jacoboropero-web/segunda-entrega-proyecto/imagenes/3d_vista_inferior.png

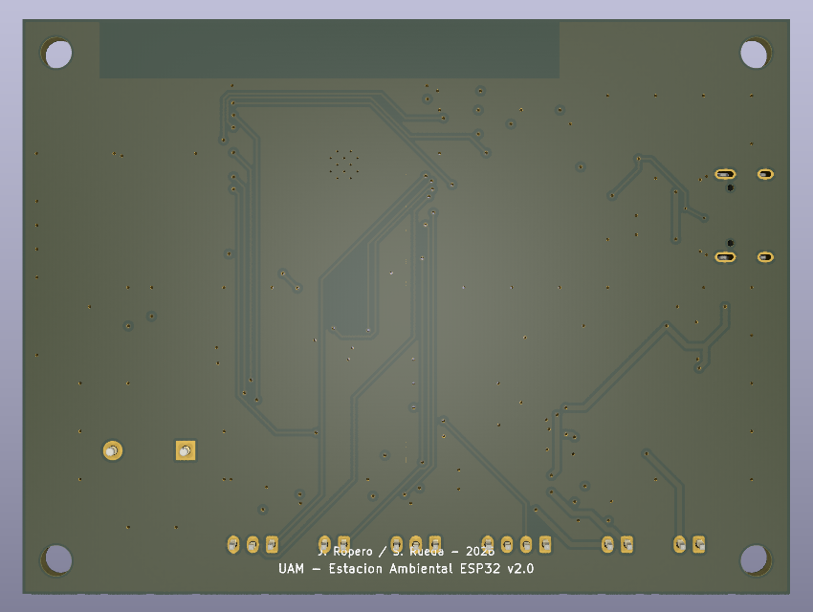
imagenes/3d_vista_inferior.png
