jacoboropero-web/segunda-entrega-proyecto/imagenes/3d_vista_superior.png

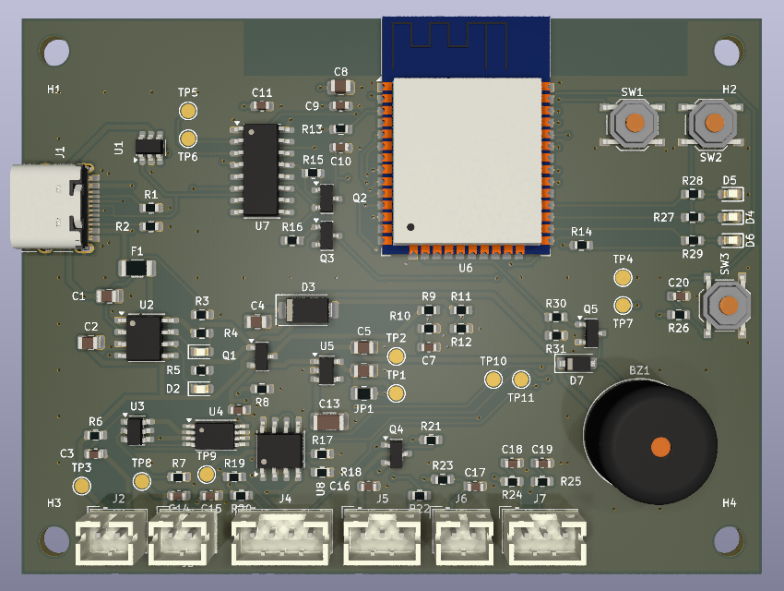
imagenes/3d_vista_superior.png
