jacoboropero-web/segunda-entrega-proyecto/imagenes/3d_perspectiva.png

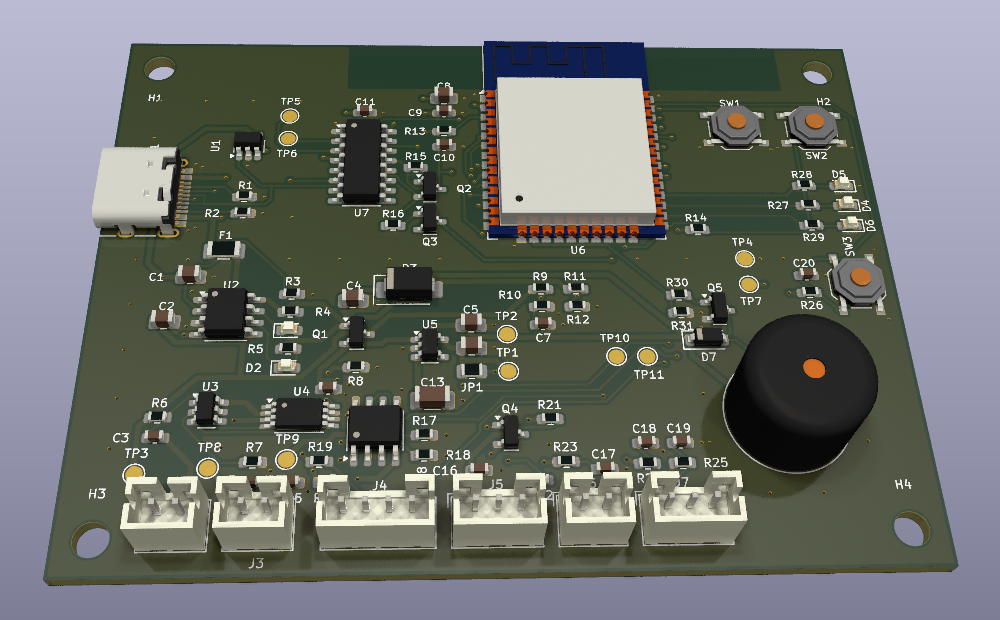
imagenes/3d_perspectiva.png
