jacoboropero-web/segunda-entrega-proyecto/imagenes/erc_kicad_0_errores.png

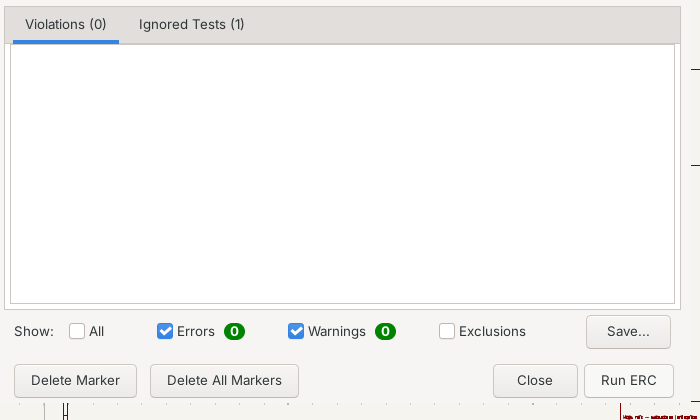
imagenes/erc_kicad_0_errores.png
