jacoboropero-web/segunda-entrega-proyecto/imagenes/esquema_alimentacion.png

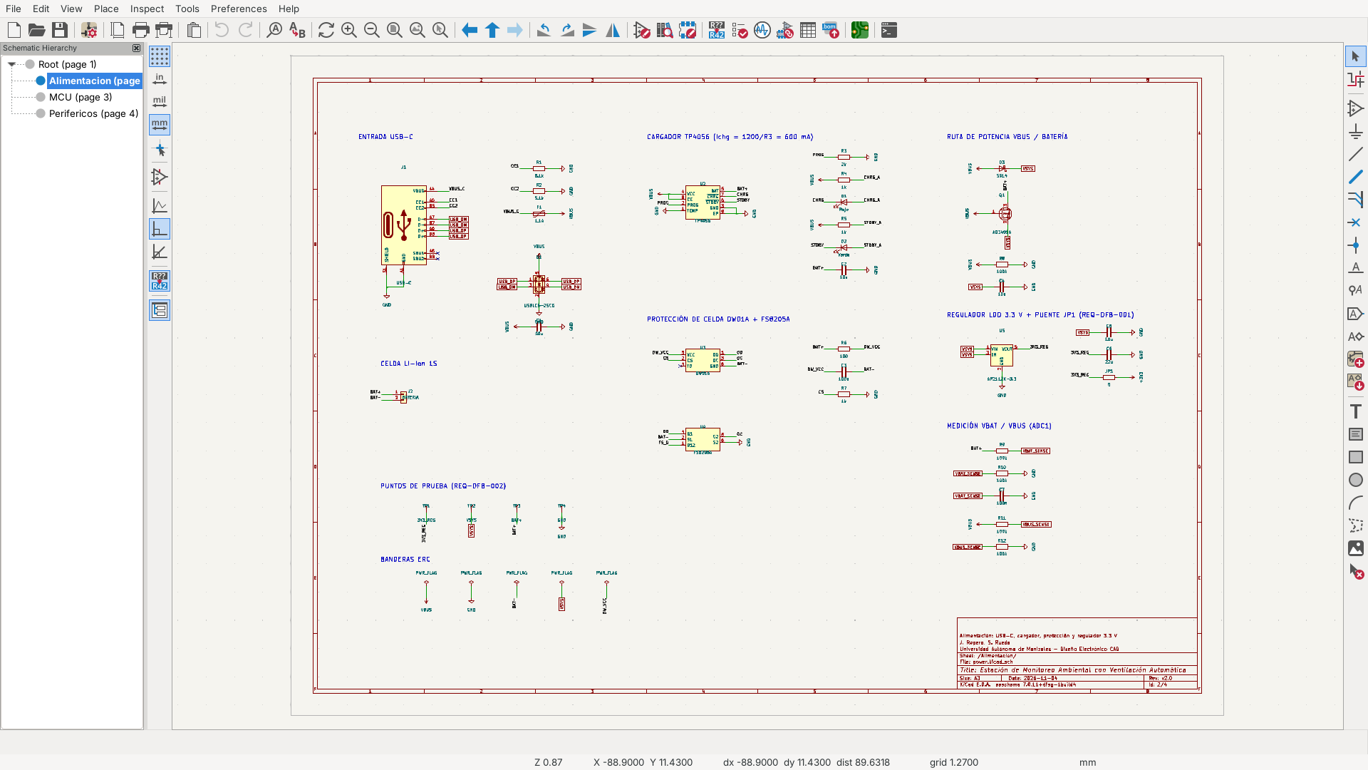
imagenes/esquema_alimentacion.png
