jacoboropero-web/segunda-entrega-proyecto/imagenes/esquema_hoja_raiz.png

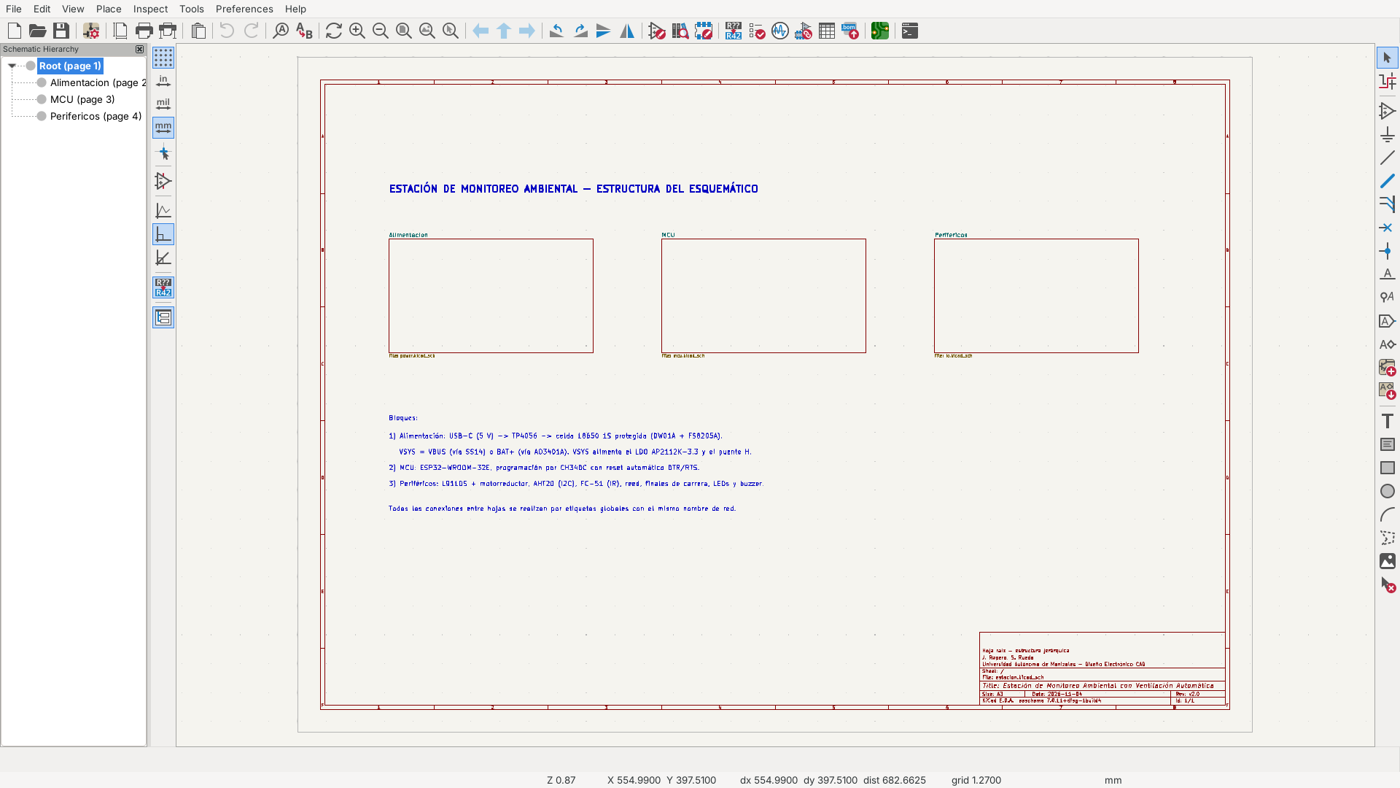
imagenes/esquema_hoja_raiz.png
