jacoboropero-web/segunda-entrega-proyecto/imagenes/esquema_mcu.png

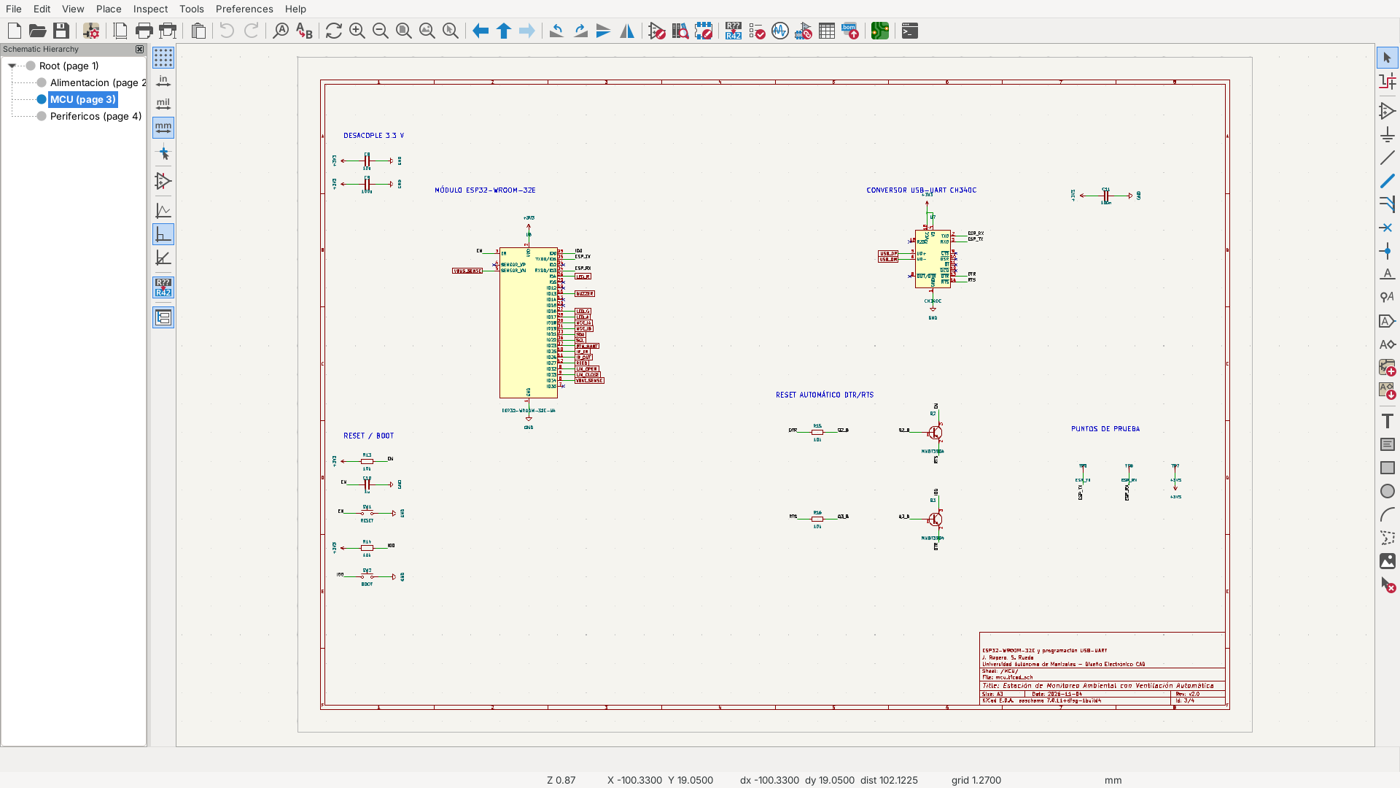
imagenes/esquema_mcu.png
