jacoboropero-web/segunda-entrega-proyecto/imagenes/esquema_perifericos.png

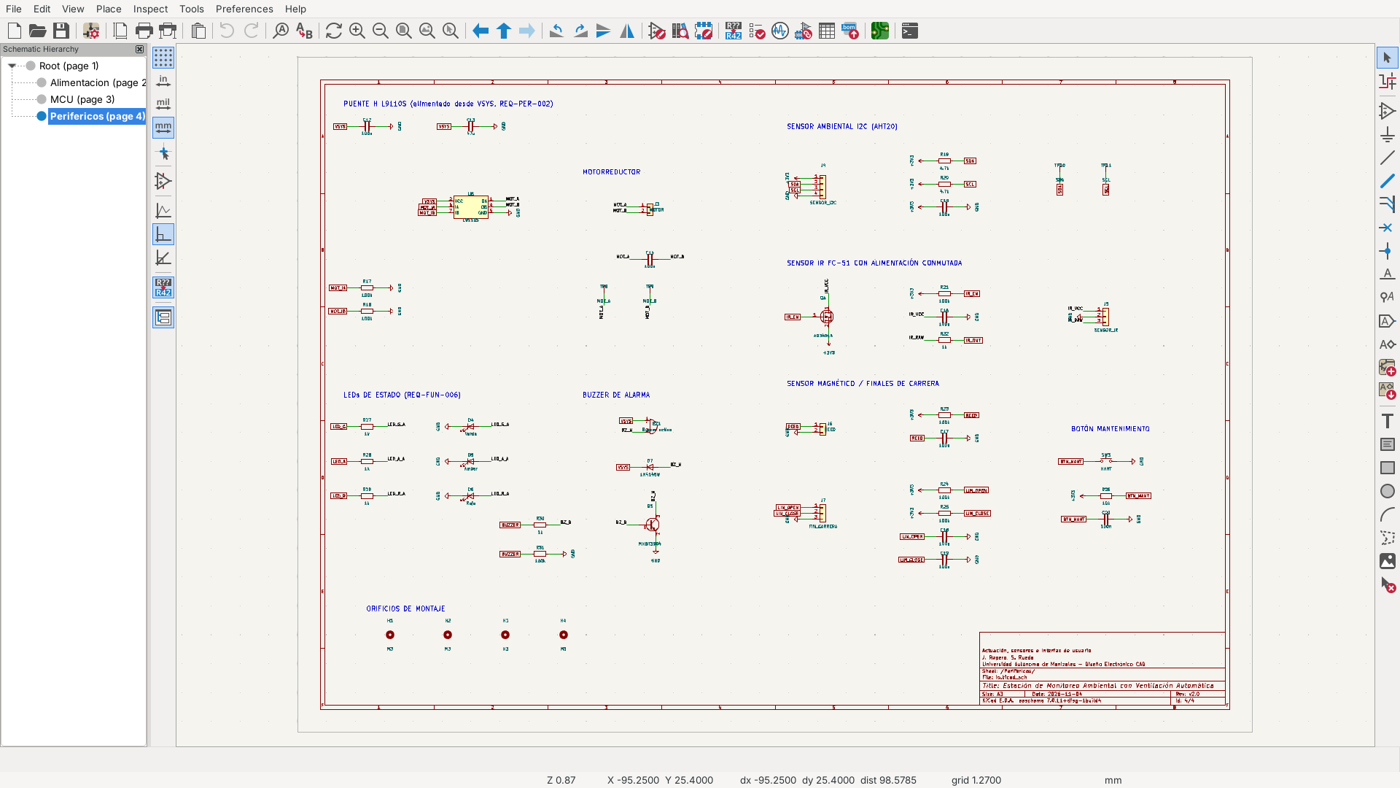
imagenes/esquema_perifericos.png
