jacoboropero-web/segunda-entrega-proyecto/imagenes/layout_kicad.png

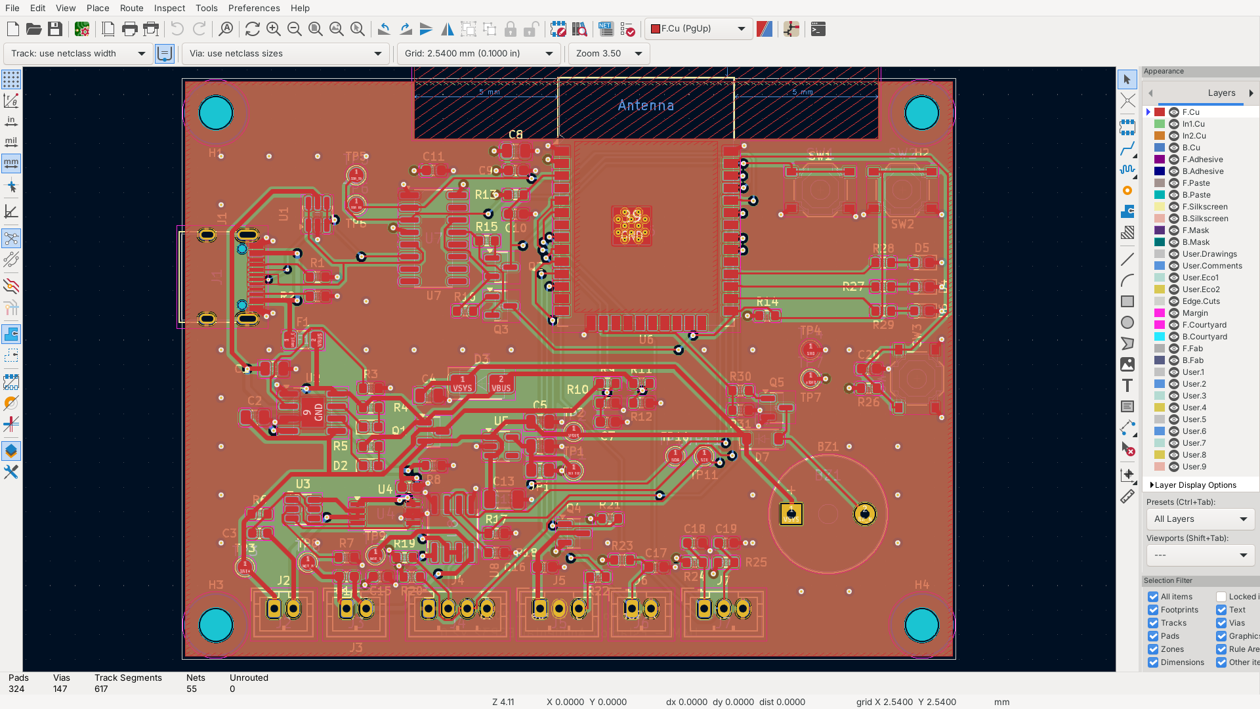
imagenes/layout_kicad.png
