jacoboropero-web/segunda-entrega-proyecto/imagenes/pistas_capas_superior_inferior.png

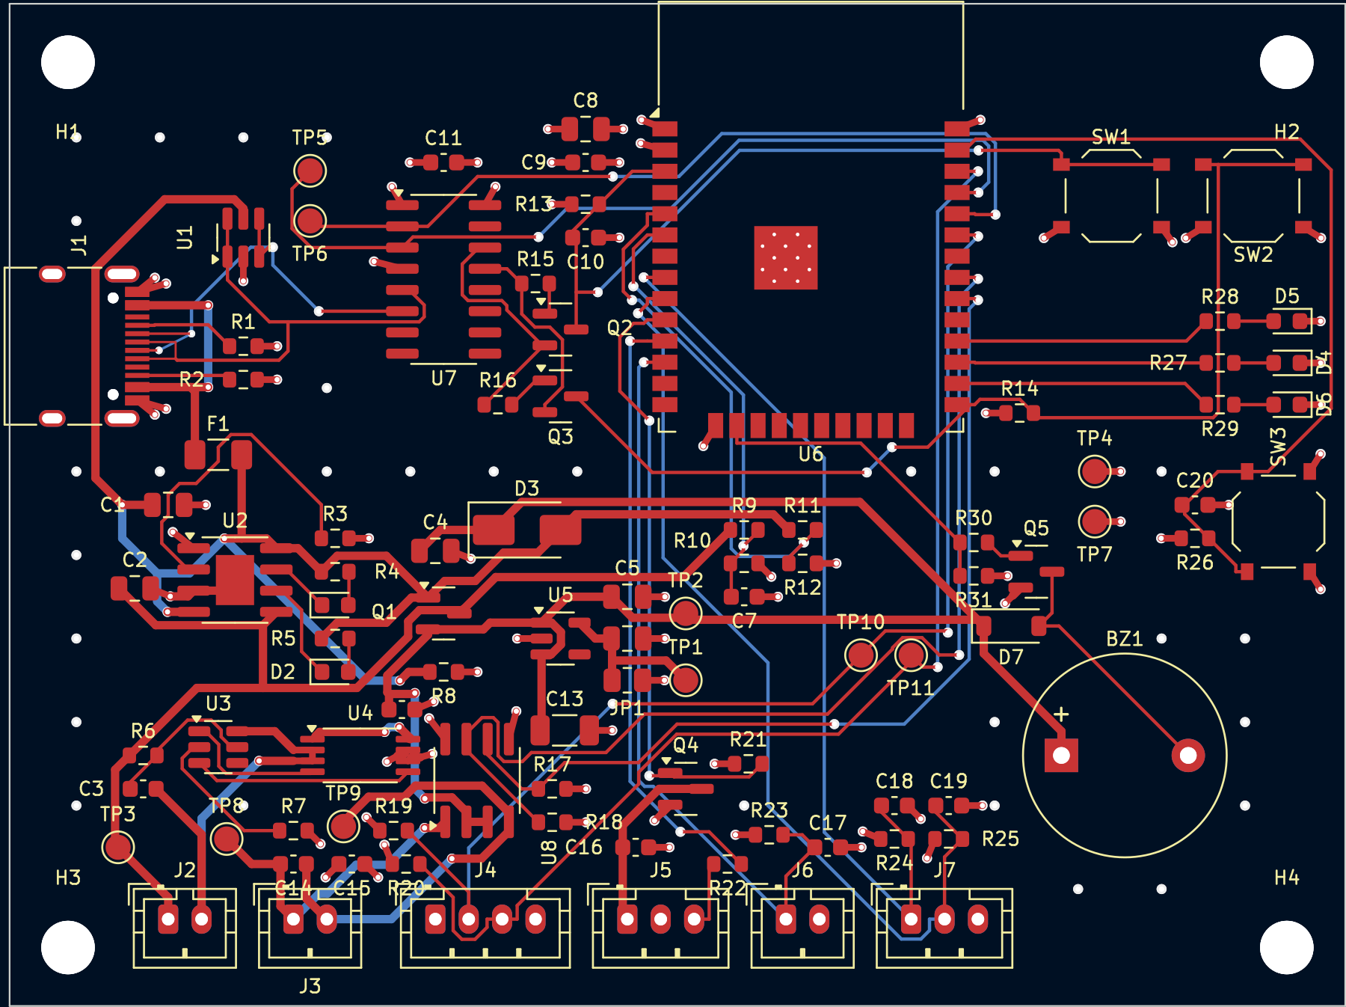
imagenes/pistas_capas_superior_inferior.png
