jacoboropero-web/segunda-entrega-proyecto/imagenes/ratsnest_conexiones_kicad.png

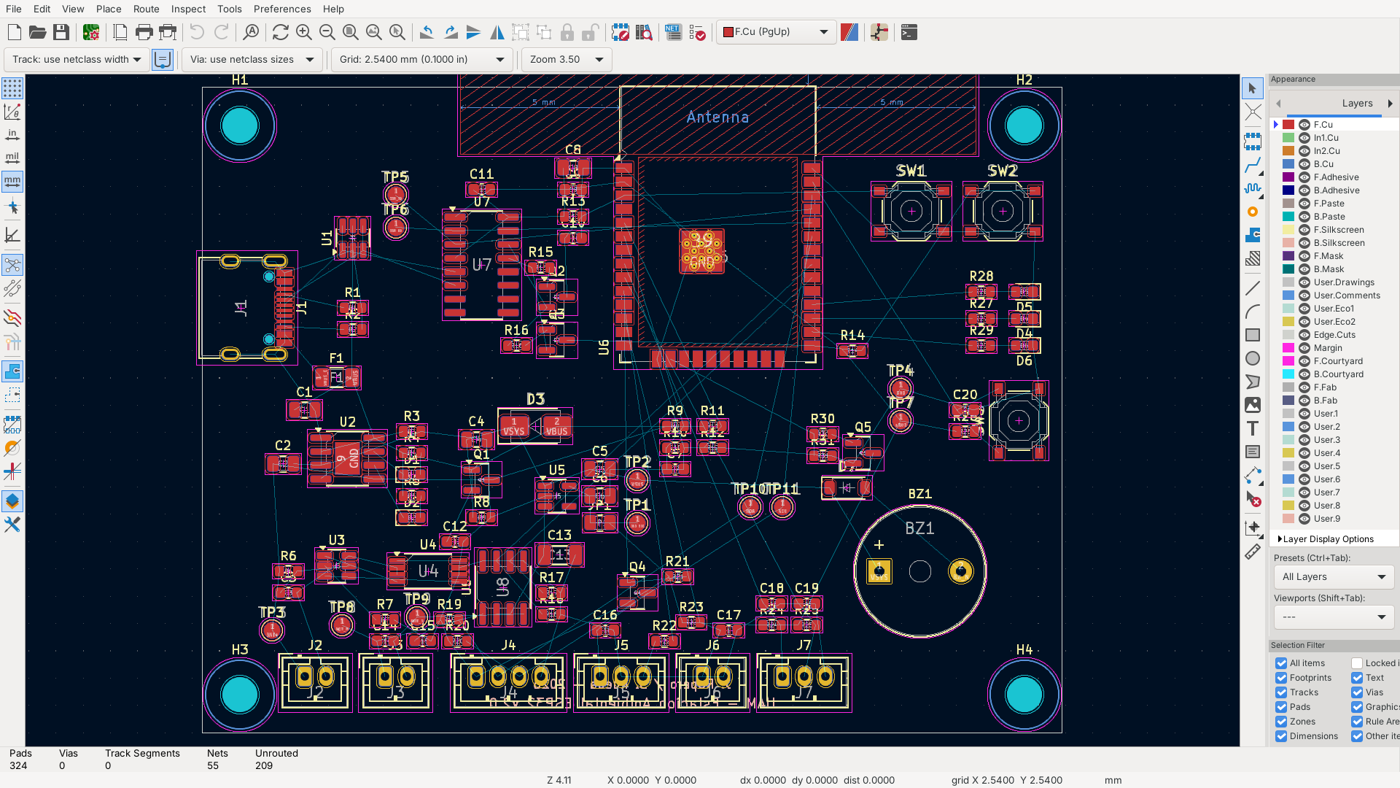
imagenes/ratsnest_conexiones_kicad.png
