jacoboropero-web/segunda-entrega-proyecto/hardware/estacion_kicad/fab/estacion-BOM-JLCPCB.csv

Comment | Designator | Footprint | LCSC Part #
USB-C | J1 | USB_C_Receptacle_HRO_TYPE-C-31-M-12 | C165948
5.1k | R1,R2 | R_0603_1608Metric
1.1A | F1 | Fuse_1206_3216Metric
USBLC6-2SC6 | U1 | SOT-23-6 | C7519
10u | C1,C2,C4,C5,C8 | C_0805_2012Metric
TP4056 | U2 | SOIC-8-1EP_3.9x4.9mm_P1.27mm_EP2.29x3mm | C16581
2k | R3 | R_0603_1608Metric
1k | R4,R5,R7,R22,R27,R28,R29,R30 | R_0603_1608Metric
Rojo | D1,D6 | LED_0603_1608Metric
Verde | D2,D4 | LED_0603_1608Metric
DW01A | U3 | SOT-23-6 | C351410
FS8205A | U4 | TSSOP-8_4.4x3mm_P0.65mm | C16052
100 | R6 | R_0603_1608Metric
100n | C3,C7,C9,C11,C12,C14,C15,C16,C17,C18,C19,C20 | C_0603_1608Metric
SS14 | D3 | D_SMA | C2480
AO3401A | Q1,Q4 | SOT-23 | C15127
100k | R8,R9,R10,R11,R12,R17,R18,R21,R23,R24,R25,R31 | R_0603_1608Metric
AP2112K-3.3 | U5 | SOT-23-5 | C51118
22u | C6 | C_0805_2012Metric
0 | JP1 | R_0805_2012Metric
ESP32-WROOM-32E-N4 | U6 | ESP32-WROOM-32D | C701341
10k | R13,R14,R15,R16,R26 | R_0603_1608Metric
1u | C10 | C_0603_1608Metric
RESET | SW1 | SW_Push_1P1T_XKB_TS-1187A | C318884
BOOT | SW2 | SW_Push_1P1T_XKB_TS-1187A | C318884
CH340C | U7 | SOIC-16_3.9x9.9mm_P1.27mm | C84681
MMBT3904 | Q2,Q3,Q5 | SOT-23 | C20526
L9110S | U8 | SOIC-8_3.9x4.9mm_P1.27mm | C85174
47u | C13 | C_1206_3216Metric
4.7k | R19,R20 | R_0603_1608Metric
MANT | SW3 | SW_Push_1P1T_XKB_TS-1187A | C318884
Ambar | D5 | LED_0603_1608Metric
1N4148W | D7 | D_SOD-123 | C81598
