jacoboropero-web/segunda-entrega-proyecto/hardware/estacion_kicad/fab/estacion-BOM.csv

Comment | Designator | Footprint | Cantidad | MPN | LCSC | Tipo | Clase | Precio_USD | Subtotal_USD
USB-C | J1 | USB_C_Receptacle_HRO_TYPE-C-31-M-12 | 1 | HRO TYPE-C-31-M-12 | C165948 | SMD | Extendida | 0.15 | 0.15
5.1k | R1,R2 | R_0603_1608Metric | 2 | 0603 5.1k 1% | (básico JLC) | SMD | Básica | 0.01 | 0.02
1.1A | F1 | Fuse_1206_3216Metric | 1 | 1206L110 (PTC 1.1 A) |  | SMD | Extendida | 0.03 | 0.03
USBLC6-2SC6 | U1 | SOT-23-6 | 1 | USBLC6-2SC6 | C7519 | SMD | Básica | 0.1 | 0.1
10u | C1,C2,C4,C5,C8 | C_0805_2012Metric | 5 | 10uF 16V X5R 0805 | (básico JLC) | SMD | Básica | 0.01 | 0.05
TP4056 | U2 | SOIC-8-1EP_3.9x4.9mm_P1.27mm_EP2.29x3mm | 1 | TP4056 (ESOP-8) | C16581 | SMD | Extendida | 0.1 | 0.1
2k | R3 | R_0603_1608Metric | 1 | 0603 2k 1% | (básico JLC) | SMD | Básica | 0.01 | 0.01
1k | R4,R5,R7,R22,R27,R28,R29,R30 | R_0603_1608Metric | 8 | 0603 1k 1% | (básico JLC) | SMD | Básica | 0.01 | 0.08
Rojo | D1,D6 | LED_0603_1608Metric | 2 | LED 0603 Rojo | (básico JLC) | SMD | Básica | 0.01 | 0.02
Verde | D2,D4 | LED_0603_1608Metric | 2 | LED 0603 Verde | (básico JLC) | SMD | Básica | 0.01 | 0.02
DW01A | U3 | SOT-23-6 | 1 | DW01A | C351410 | SMD | Extendida | 0.04 | 0.04
FS8205A | U4 | TSSOP-8_4.4x3mm_P0.65mm | 1 | FS8205A | C16052 | SMD | Extendida | 0.06 | 0.06
100 | R6 | R_0603_1608Metric | 1 | 0603 100 1% | (básico JLC) | SMD | Básica | 0.01 | 0.01
100n | C3,C7,C9,C11,C12,C14,C15,C16,C17,C18,C19,C20 | C_0603_1608Metric | 12 | 100n | (básico JLC) | SMD | Básica | 0.01 | 0.12
BATERIA | J2 | JST_PH_B2B-PH-K_1x02_P2.00mm_Vertical | 1 | JST PH 2P (celda 18650 1S) |  | THT (manual) | Básica | 0.06 | 0.06
SS14 | D3 | D_SMA | 1 | SS14 40V 1A Schottky | C2480 | SMD | Básica | 0.02 | 0.02
AO3401A | Q1,Q4 | SOT-23 | 2 | AO3401A P-MOSFET | C15127 | SMD | Básica | 0.02 | 0.04
100k | R8,R9,R10,R11,R12,R17,R18,R21,R23,R24,R25,R31 | R_0603_1608Metric | 12 | 0603 100k 1% | (básico JLC) | SMD | Básica | 0.01 | 0.12
AP2112K-3.3 | U5 | SOT-23-5 | 1 | AP2112K-3.3TRG1 | C51118 | SMD | Extendida | 0.09 | 0.09
22u | C6 | C_0805_2012Metric | 1 | 22uF 10V X5R 0805 | (básico JLC) | SMD | Básica | 0.01 | 0.01
0 | JP1 | R_0805_2012Metric | 1 | Puente 0 Ohm 0805 (REQ-DFB-001) | (básico JLC) | SMD | Básica | 0.01 | 0.01
ESP32-WROOM-32E-N4 | U6 | ESP32-WROOM-32D | 1 | ESP32-WROOM-32E-N4 | C701341 | SMD | Extendida | 3.2 | 3.2
10k | R13,R14,R15,R16,R26 | R_0603_1608Metric | 5 | 0603 10k 1% | (básico JLC) | SMD | Básica | 0.01 | 0.05
1u | C10 | C_0603_1608Metric | 1 | 1u | (básico JLC) | SMD | Básica | 0.01 | 0.01
RESET | SW1 | SW_Push_1P1T_XKB_TS-1187A | 1 | TS-1187A | C318884 | SMD | Básica | 0.03 | 0.03
BOOT | SW2 | SW_Push_1P1T_XKB_TS-1187A | 1 | TS-1187A | C318884 | SMD | Básica | 0.03 | 0.03
CH340C | U7 | SOIC-16_3.9x9.9mm_P1.27mm | 1 | CH340C | C84681 | SMD | Extendida | 0.45 | 0.45
MMBT3904 | Q2,Q3,Q5 | SOT-23 | 3 | MMBT3904 | C20526 | SMD | Básica | 0.01 | 0.03
L9110S | U8 | SOIC-8_3.9x4.9mm_P1.27mm | 1 | L9110S (SOP-8) | C85174 | SMD | Extendida | 0.1 | 0.1
47u | C13 | C_1206_3216Metric | 1 | 47uF 10V X5R 1206 | (básico JLC) | SMD | Básica | 0.01 | 0.01
MOTOR | J3 | JST_PH_B2B-PH-K_1x02_P2.00mm_Vertical | 1 | JST PH 2P |  | THT (manual) | Básica | 0.06 | 0.06
SENSOR_I2C | J4 | JST_PH_B4B-PH-K_1x04_P2.00mm_Vertical | 1 | JST PH 4P (módulo AHT20) |  | THT (manual) | Básica | 0.06 | 0.06
4.7k | R19,R20 | R_0603_1608Metric | 2 | 0603 4.7k 1% | (básico JLC) | SMD | Básica | 0.01 | 0.02
SENSOR_IR | J5 | JST_PH_B3B-PH-K_1x03_P2.00mm_Vertical | 1 | JST PH 3P (módulo FC-51) |  | THT (manual) | Básica | 0.06 | 0.06
REED | J6 | JST_PH_B2B-PH-K_1x02_P2.00mm_Vertical | 1 | JST PH 2P |  | THT (manual) | Básica | 0.06 | 0.06
FIN_CARRERA | J7 | JST_PH_B3B-PH-K_1x03_P2.00mm_Vertical | 1 | JST PH 3P |  | THT (manual) | Básica | 0.06 | 0.06
MANT | SW3 | SW_Push_1P1T_XKB_TS-1187A | 1 | TS-1187A | C318884 | SMD | Básica | 0.03 | 0.03
Ambar | D5 | LED_0603_1608Metric | 1 | LED 0603 Ambar | (básico JLC) | SMD | Básica | 0.01 | 0.01
Buzzer activo | BZ1 | Buzzer_12x9.5RM7.6 | 1 | Buzzer activo 12 mm 3-5 V |  | THT (manual) | Básica | 0.3 | 0.3
1N4148W | D7 | D_SOD-123 | 1 | 1N4148W | C81598 | SMD | Básica | 0.01 | 0.01
