jacoboropero-web/segunda-entrega-proyecto/imagenes/pistas_todo_conectado_kicad.png

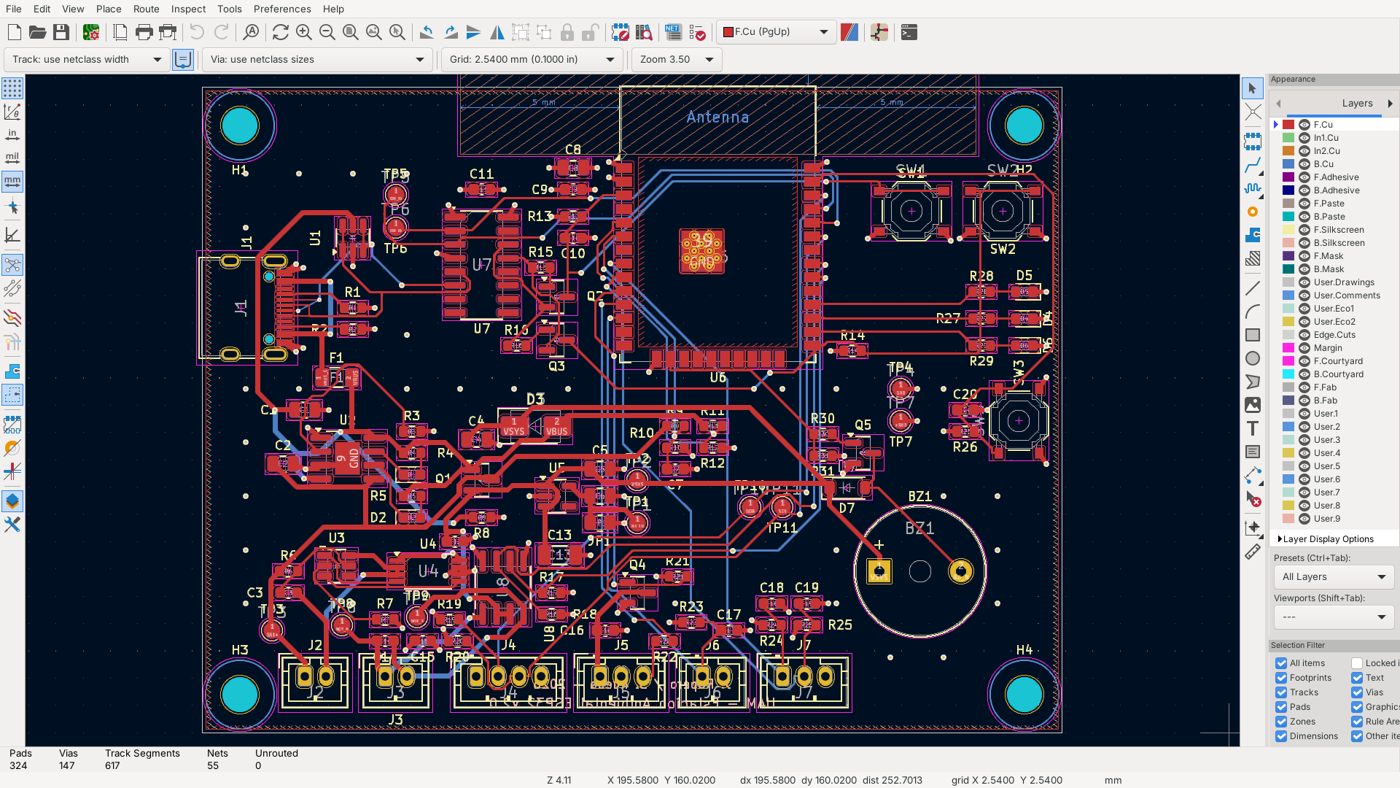
imagenes/pistas_todo_conectado_kicad.png
