jacoboropero-web/segunda-entrega-proyecto/hardware/estacion_kicad/estacion.kicad_pcb

## KiCad design hardware/estacion_kicad/estacion.kicad_pcb (2026-11-05)

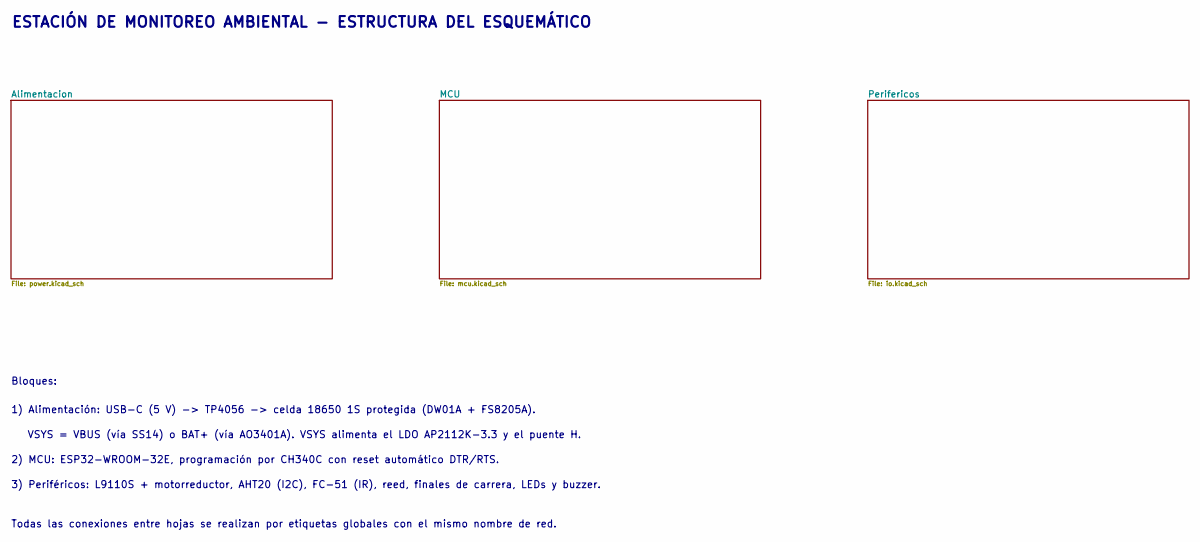
[picture p13: schematic estacion.kicad_sch, Estación de Monitoreo Ambiental con Ventilación Automática]

Notes on the sheet:
ESTACIÓN DE MONITOREO AMBIENTAL - ESTRUCTURA DEL ESQUEMÁTICO
Bloques:
1) Alimentación: USB-C (5 V) -> TP4056 -> celda 18650 1S protegida (DW01A + FS8205A).
VSYS = VBUS (vía SS14) o BAT+ (vía AO3401A). VSYS alimenta el LDO AP2112K-3.3 y el puente H.
2) MCU: ESP32-WROOM-32E, programación por CH340C con reset automático DTR/RTS.
3) Periféricos: L9110S + motorreductor, AHT20 (I2C), FC-51 (IR), reed, finales de carrera, LEDs y buzzer.
Todas las conexiones entre hojas se realizan por etiquetas globales con el mismo nombre de red.

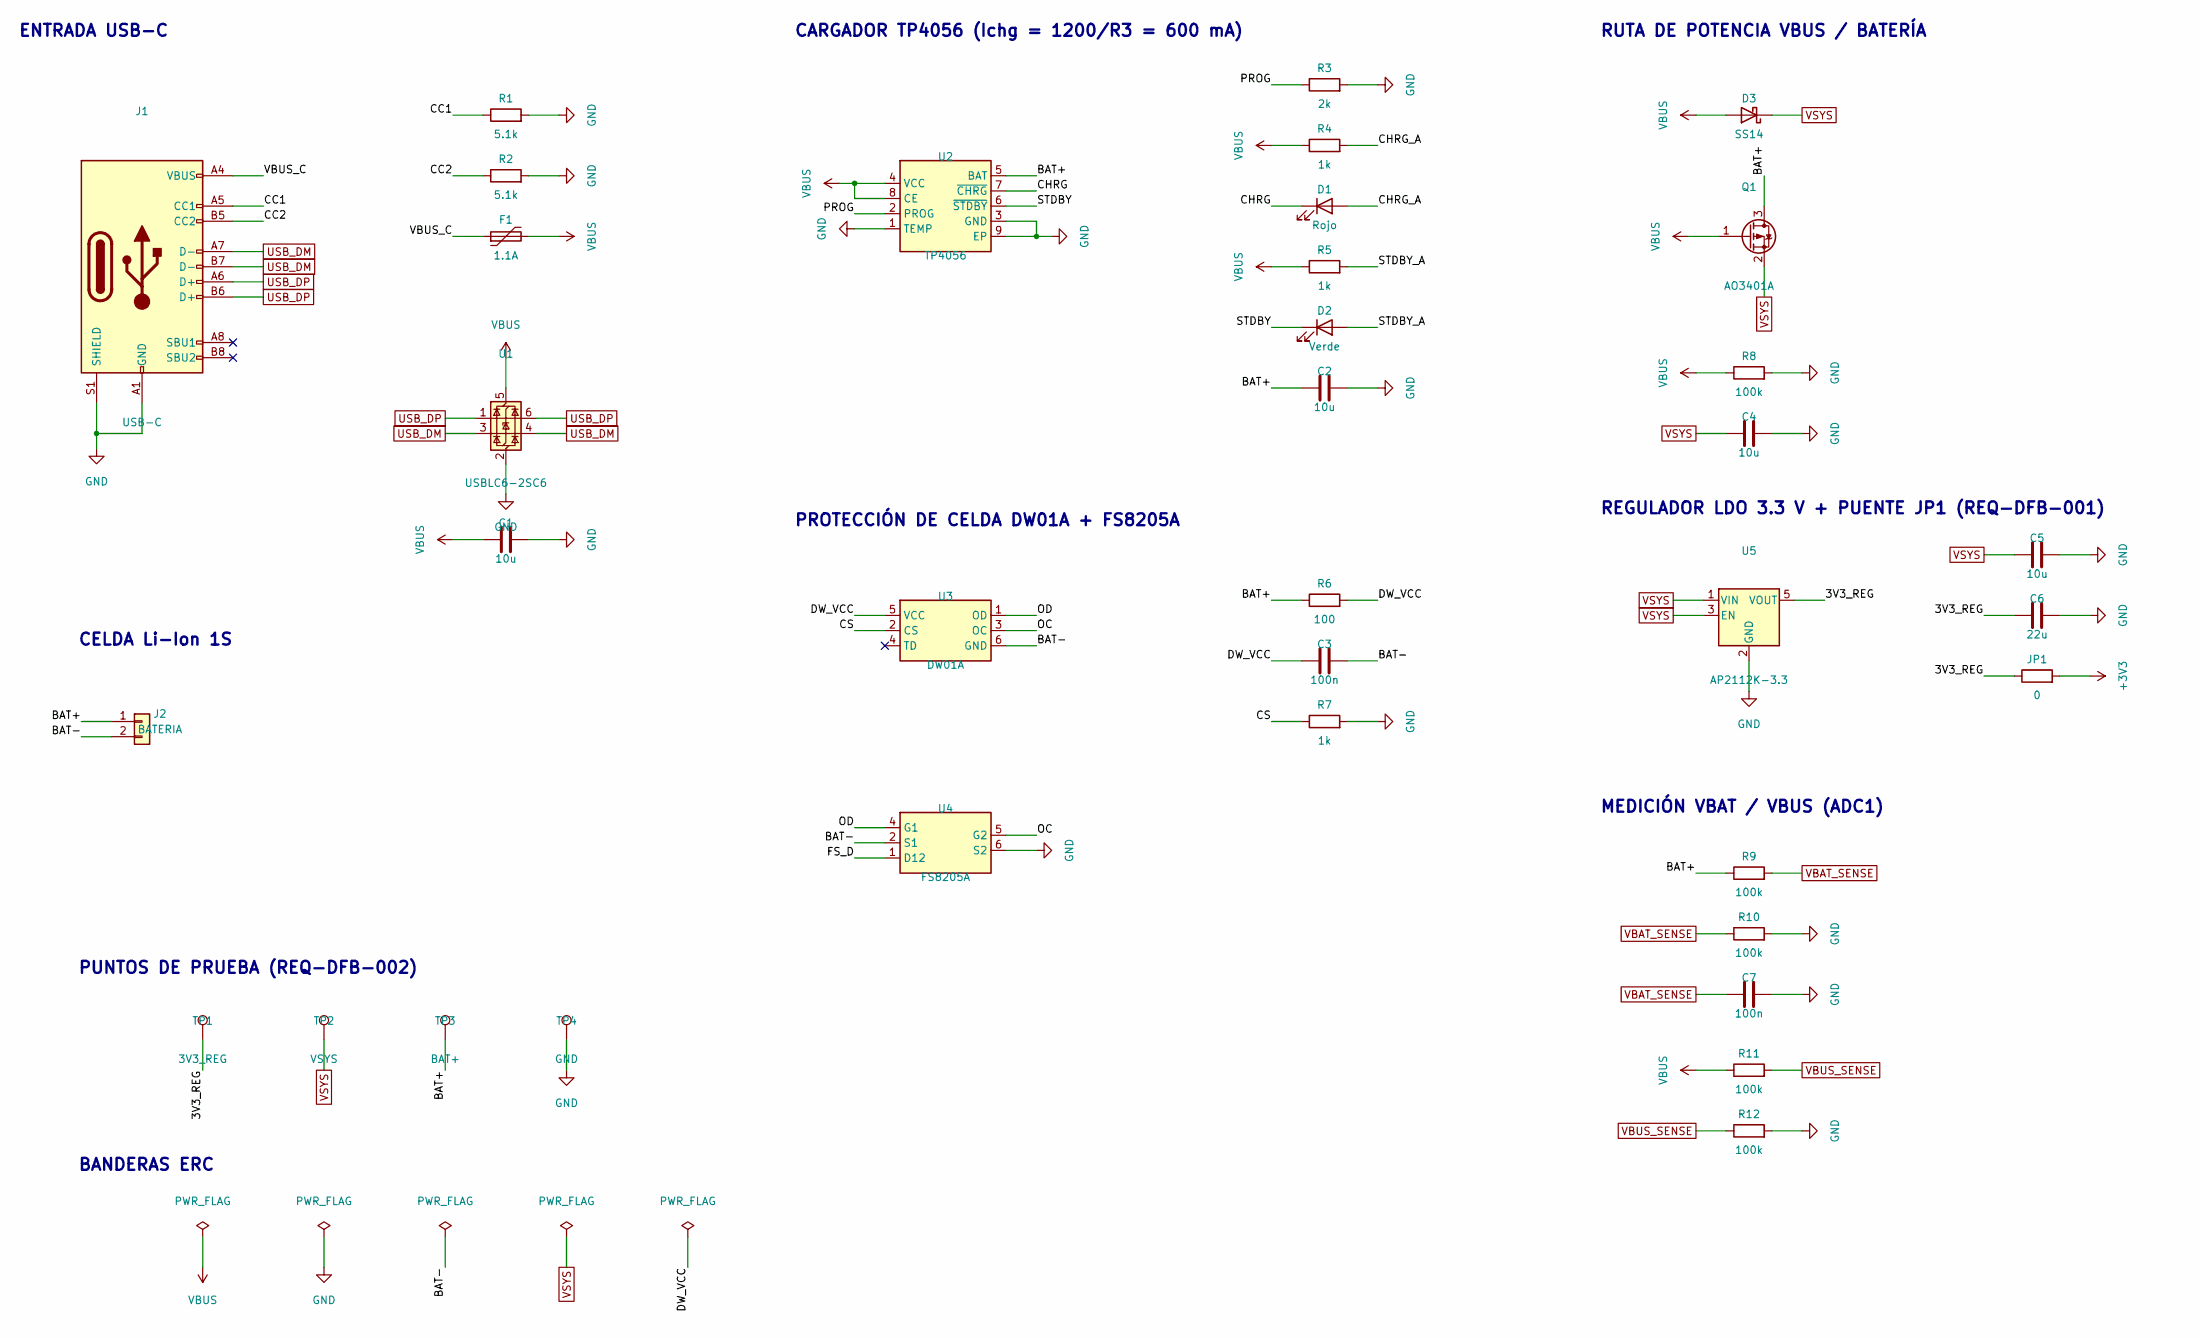
[picture p14: schematic power.kicad_sch, Estación de Monitoreo Ambiental con Ventilación Automática]

Parts:
C1, C2, C4, C5: 10u; C_0805_2012Metric; MPN 10uF 16V X5R 0805
C3, C7: 100n; C_0603_1608Metric; MPN 100n
C6: 22u; C_0805_2012Metric; MPN 22uF 10V X5R 0805
D1: Rojo; LED_0603_1608Metric; MPN LED 0603 Rojo
D2: Verde; LED_0603_1608Metric; MPN LED 0603 Verde
D3: SS14; D_SMA; MPN SS14 40V 1A Schottky
F1: 1.1A; Fuse_1206_3216Metric; MPN 1206L110 (PTC 1.1 A)
J1: USB-C; USB_C_Receptacle_HRO_TYPE-C-31-M-12; MPN HRO TYPE-C-31-M-12
J2: BATERIA; JST_PH_B2B-PH-K_1x02_P2.00mm_Vertical; MPN JST PH 2P (celda 18650 1S)
JP1: 0; R_0805_2012Metric; MPN Puente 0 Ohm 0805 (REQ-DFB-001)
Q1: AO3401A; SOT-23; MPN AO3401A P-MOSFET
R1, R2: 5.1k; R_0603_1608Metric; MPN 0603 5.1k 1%
R3: 2k; R_0603_1608Metric; MPN 0603 2k 1%
R4, R5, R7: 1k; R_0603_1608Metric; MPN 0603 1k 1%
R6: 100; R_0603_1608Metric; MPN 0603 100 1%
R8, R9, R10, R11, R12: 100k; R_0603_1608Metric; MPN 0603 100k 1%
TP1: 3V3_REG; TestPoint_Pad_D1.5mm; MPN Pad prueba 1.5 mm
TP2: VSYS; TestPoint_Pad_D1.5mm; MPN Pad prueba 1.5 mm
TP3: BAT+; TestPoint_Pad_D1.5mm; MPN Pad prueba 1.5 mm
TP4: GND; TestPoint_Pad_D1.5mm; MPN Pad prueba 1.5 mm
U1: USBLC6-2SC6; SOT-23-6; MPN USBLC6-2SC6
U2: TP4056; SOIC-8-1EP_3.9x4.9mm_P1.27mm_EP2.29x3mm; MPN TP4056 (ESOP-8)
U3: DW01A; SOT-23-6; MPN DW01A
U4: FS8205A; TSSOP-8_4.4x3mm_P0.65mm; MPN FS8205A
U5: AP2112K-3.3; SOT-23-5; MPN AP2112K-3.3TRG1

Connections:
3V3_REG: C6.1, JP1.1, TP1.1, U5.5 (VOUT)
+3V3: JP1.2; also elsewhere on the board
BAT+: C2.1, J2.1, Q1.3 (D), R6.1, R9.1, TP3.1, U2.5 (BAT)
BAT-: C3.2, J2.2, U3.6 (GND), U4.2 (S1), U4.3 (S1)
CC1: J1.A5 (CC1), R1.1
CC2: J1.B5 (CC2), R2.1
CHRG: D1.1 (K), U2.7 (~CHRG)
CHRG_A: D1.2 (A), R4.2
CS: R7.1, U3.2 (CS)
DW_VCC: C3.1, R6.2, U3.5 (VCC)
FS_D: U4.1 (D12), U4.8 (D12)
GND: C1.2, C2.2, C4.2, C5.2, C6.2, C7.2, J1.A1 (GND), J1.A12 (GND), J1.B1 (GND), J1.B12 (GND), J1.S1 (SHIELD), R1.2, R2.2, R3.2, R7.2, R8.2, R10.2, R12.2, TP4.1, U1.2 (GND), U2.1 (TEMP), U2.3 (GND), U2.9 (EP), U4.6 (S2), U4.7 (S2), U5.2 (GND); also elsewhere on the board
OC: U3.3 (OC), U4.5 (G2)
OD: U3.1 (OD), U4.4 (G1)
PROG: R3.1, U2.2 (PROG)
STDBY: D2.1 (K), U2.6 (~STDBY)
STDBY_A: D2.2 (A), R5.2
USB_DM: J1.A7 (D-), J1.B7 (D-), U1.3 (I/O2), U1.4 (I/O2); also elsewhere on the board
USB_DP: J1.A6 (D+), J1.B6 (D+), U1.1 (I/O1), U1.6 (I/O1); also elsewhere on the board
VBAT_SENSE: C7.1, R9.2, R10.1; also elsewhere on the board
VBUS: C1.1, D3.2 (A), F1.2, Q1.1 (G), R4.1, R5.1, R8.1, R11.1, U1.5 (VBUS), U2.4 (VCC), U2.8 (CE)
VBUS_C: F1.1, J1.A4 (VBUS), J1.A9 (VBUS), J1.B4 (VBUS), J1.B9 (VBUS)
VBUS_SENSE: R11.2, R12.1; also elsewhere on the board
VSYS: C4.1, C5.1, D3.1 (K), Q1.2 (S), TP2.1, U5.1 (VIN), U5.3 (EN); also elsewhere on the board

Notes on the sheet:
ENTRADA USB-C
CARGADOR TP4056 (Ichg = 1200/R3 = 600 mA)
PROTECCIÓN DE CELDA DW01A + FS8205A
RUTA DE POTENCIA VBUS / BATERÍA
REGULADOR LDO 3.3 V + PUENTE JP1 (REQ-DFB-001)
MEDICIÓN VBAT / VBUS (ADC1)
CELDA Li-Ion 1S
PUNTOS DE PRUEBA (REQ-DFB-002)
BANDERAS ERC

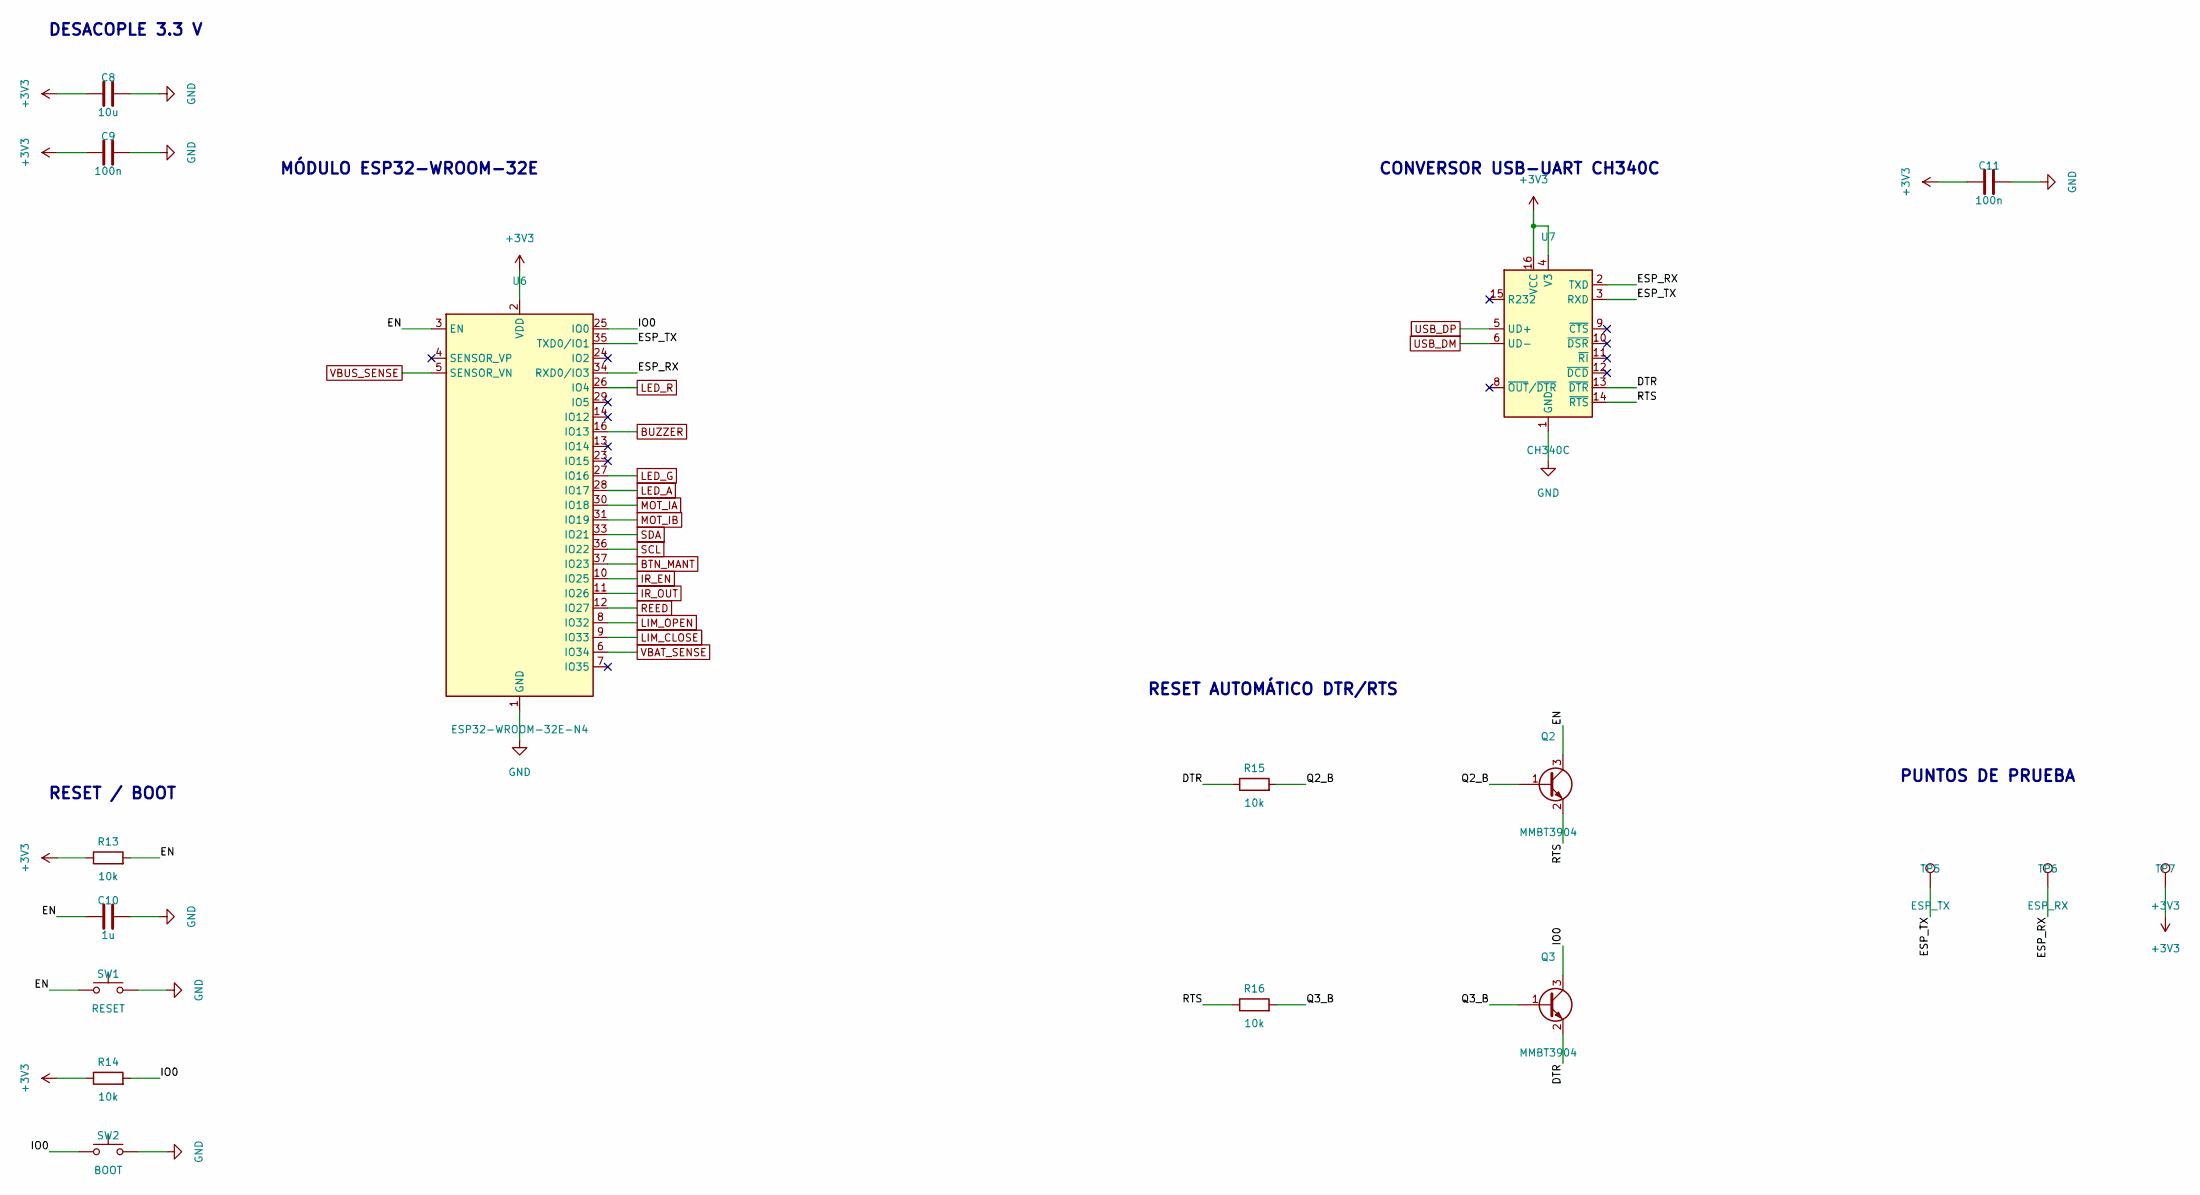
[picture p15: schematic mcu.kicad_sch, Estación de Monitoreo Ambiental con Ventilación Automática]

Parts:
C8: 10u; C_0805_2012Metric; MPN 10uF 16V X5R 0805
C9, C11: 100n; C_0603_1608Metric; MPN 100n
C10: 1u; C_0603_1608Metric; MPN 1u
Q2, Q3: MMBT3904; SOT-23; MPN MMBT3904
R13, R14, R15, R16: 10k; R_0603_1608Metric; MPN 0603 10k 1%
SW1: RESET; SW_Push_1P1T_XKB_TS-1187A; MPN TS-1187A
SW2: BOOT; SW_Push_1P1T_XKB_TS-1187A; MPN TS-1187A
TP5: ESP_TX; TestPoint_Pad_D1.5mm; MPN Pad prueba 1.5 mm
TP6: ESP_RX; TestPoint_Pad_D1.5mm; MPN Pad prueba 1.5 mm
TP7: +3V3; TestPoint_Pad_D1.5mm; MPN Pad prueba 1.5 mm
U6: ESP32-WROOM-32E-N4; ESP32-WROOM-32D; MPN ESP32-WROOM-32E-N4
U7: CH340C; SOIC-16_3.9x9.9mm_P1.27mm; MPN CH340C

Connections:
+3V3: C8.1, C9.1, C11.1, R13.1, R14.1, TP7.1, U6.2 (VDD), U7.4 (V3), U7.16 (VCC); also elsewhere on the board
BTN_MANT: U6.37 (IO23); also elsewhere on the board
BUZZER: U6.16 (IO13); also elsewhere on the board
DTR: Q3.2 (E), R15.1, U7.13 (~DTR)
EN: C10.1, Q2.3 (C), R13.2, SW1.1, U6.3 (EN)
ESP_RX: TP6.1, U6.34 (RXD0/IO3), U7.2 (TXD)
ESP_TX: TP5.1, U6.35 (TXD0/IO1), U7.3 (RXD)
GND: C8.2, C9.2, C10.2, C11.2, SW1.2, SW2.2, U6.1 (GND), U6.15 (GND), U6.38 (GND), U6.39 (GND), U7.1 (GND); also elsewhere on the board
IO0: Q3.3 (C), R14.2, SW2.1, U6.25 (IO0)
IR_EN: U6.10 (IO25); also elsewhere on the board
IR_OUT: U6.11 (IO26); also elsewhere on the board
LED_A: U6.28 (IO17); also elsewhere on the board
LED_G: U6.27 (IO16); also elsewhere on the board
LED_R: U6.26 (IO4); also elsewhere on the board
LIM_CLOSE: U6.9 (IO33); also elsewhere on the board
LIM_OPEN: U6.8 (IO32); also elsewhere on the board
MOT_IA: U6.30 (IO18); also elsewhere on the board
MOT_IB: U6.31 (IO19); also elsewhere on the board
Q2_B: Q2.1 (B), R15.2
Q3_B: Q3.1 (B), R16.2
REED: U6.12 (IO27); also elsewhere on the board
RTS: Q2.2 (E), R16.1, U7.14 (~RTS)
SCL: U6.36 (IO22); also elsewhere on the board
SDA: U6.33 (IO21); also elsewhere on the board
USB_DM: U7.6 (UD-); also elsewhere on the board
USB_DP: U7.5 (UD+); also elsewhere on the board
VBAT_SENSE: U6.6 (IO34); also elsewhere on the board
VBUS_SENSE: U6.5 (SENSOR_VN); also elsewhere on the board

Notes on the sheet:
DESACOPLE 3.3 V
MÓDULO ESP32-WROOM-32E
RESET / BOOT
CONVERSOR USB-UART CH340C
RESET AUTOMÁTICO DTR/RTS
PUNTOS DE PRUEBA

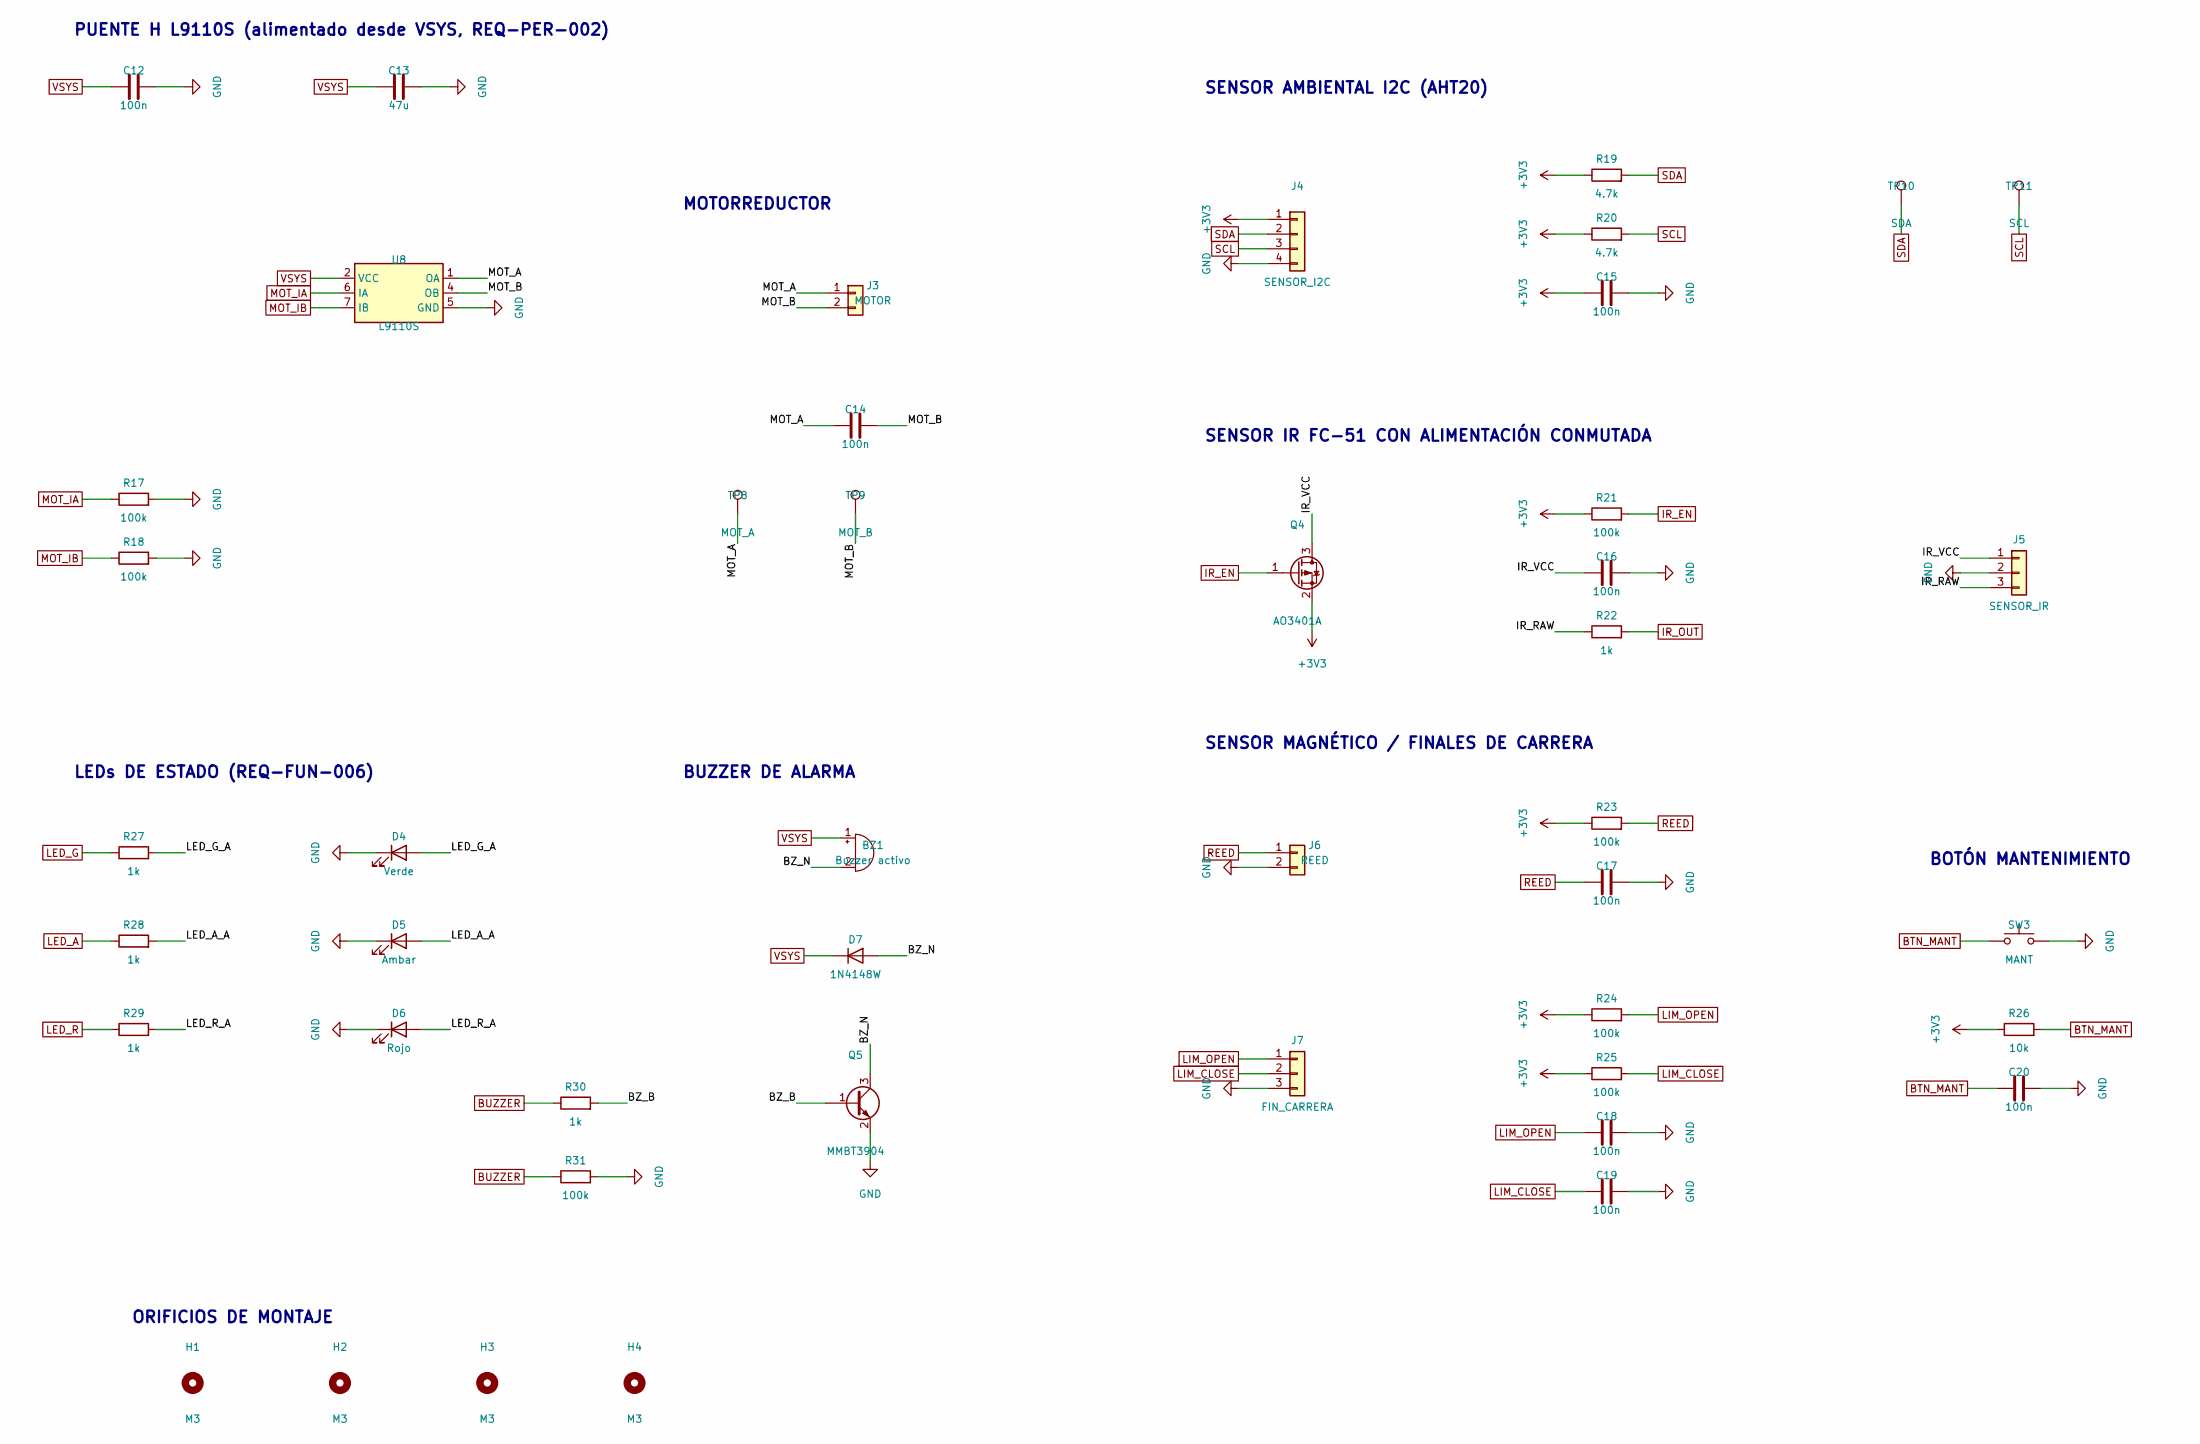
[picture p16: schematic io.kicad_sch, Estación de Monitoreo Ambiental con Ventilación Automática]

Parts:
BZ1: Buzzer activo; Buzzer_12x9.5RM7.6; MPN Buzzer activo 12 mm 3-5 V
C12, C14, C15, C16, C17, C18, C19, C20: 100n; C_0603_1608Metric; MPN 100n
C13: 47u; C_1206_3216Metric; MPN 47uF 10V X5R 1206
D4: Verde; LED_0603_1608Metric; MPN LED 0603 Verde
D5: Ambar; LED_0603_1608Metric; MPN LED 0603 Ambar
D6: Rojo; LED_0603_1608Metric; MPN LED 0603 Rojo
D7: 1N4148W; D_SOD-123; MPN 1N4148W
H1, H2, H3, H4: M3; MountingHole_3.2mm_M3; MPN Orificio M3
J3: MOTOR; JST_PH_B2B-PH-K_1x02_P2.00mm_Vertical; MPN JST PH 2P
J4: SENSOR_I2C; JST_PH_B4B-PH-K_1x04_P2.00mm_Vertical; MPN JST PH 4P (módulo AHT20)
J5: SENSOR_IR; JST_PH_B3B-PH-K_1x03_P2.00mm_Vertical; MPN JST PH 3P (módulo FC-51)
J6: REED; JST_PH_B2B-PH-K_1x02_P2.00mm_Vertical; MPN JST PH 2P
J7: FIN_CARRERA; JST_PH_B3B-PH-K_1x03_P2.00mm_Vertical; MPN JST PH 3P
Q4: AO3401A; SOT-23; MPN AO3401A P-MOSFET
Q5: MMBT3904; SOT-23; MPN MMBT3904
R17, R18, R21, R23, R24, R25, R31: 100k; R_0603_1608Metric; MPN 0603 100k 1%
R19, R20: 4.7k; R_0603_1608Metric; MPN 0603 4.7k 1%
R22, R27, R28, R29, R30: 1k; R_0603_1608Metric; MPN 0603 1k 1%
R26: 10k; R_0603_1608Metric; MPN 0603 10k 1%
SW3: MANT; SW_Push_1P1T_XKB_TS-1187A; MPN TS-1187A
TP8: MOT_A; TestPoint_Pad_D1.5mm; MPN Pad prueba 1.5 mm
TP9: MOT_B; TestPoint_Pad_D1.5mm; MPN Pad prueba 1.5 mm
TP10: SDA; TestPoint_Pad_D1.5mm; MPN Pad prueba 1.5 mm
TP11: SCL; TestPoint_Pad_D1.5mm; MPN Pad prueba 1.5 mm
U8: L9110S; SOIC-8_3.9x4.9mm_P1.27mm; MPN L9110S (SOP-8)

Connections:
+3V3: C15.1, J4.1, Q4.2 (S), R19.1, R20.1, R21.1, R23.1, R24.1, R25.1, R26.1; also elsewhere on the board
BTN_MANT: C20.1, R26.2, SW3.1; also elsewhere on the board
BUZZER: R30.1, R31.1; also elsewhere on the board
BZ_B: Q5.1 (B), R30.2
BZ_N: BZ1.2 (-), D7.2 (A), Q5.3 (C)
GND: C12.2, C13.2, C15.2, C16.2, C17.2, C18.2, C19.2, C20.2, D4.1 (K), D5.1 (K), D6.1 (K), J4.4, J5.2, J6.2, J7.3, Q5.2 (E), R17.2, R18.2, R31.2, SW3.2, U8.5 (GND), U8.8 (GND); also elsewhere on the board
IR_EN: Q4.1 (G), R21.2; also elsewhere on the board
IR_OUT: R22.2; also elsewhere on the board
IR_RAW: J5.3, R22.1
IR_VCC: C16.1, J5.1, Q4.3 (D)
LED_A: R28.1; also elsewhere on the board
LED_A_A: D5.2 (A), R28.2
LED_G: R27.1; also elsewhere on the board
LED_G_A: D4.2 (A), R27.2
LED_R: R29.1; also elsewhere on the board
LED_R_A: D6.2 (A), R29.2
LIM_CLOSE: C19.1, J7.2, R25.2; also elsewhere on the board
LIM_OPEN: C18.1, J7.1, R24.2; also elsewhere on the board
MOT_A: C14.1, J3.1, TP8.1, U8.1 (OA)
MOT_B: C14.2, J3.2, TP9.1, U8.4 (OB)
MOT_IA: R17.1, U8.6 (IA); also elsewhere on the board
MOT_IB: R18.1, U8.7 (IB); also elsewhere on the board
REED: C17.1, J6.1, R23.2; also elsewhere on the board
SCL: J4.3, R20.2, TP11.1; also elsewhere on the board
SDA: J4.2, R19.2, TP10.1; also elsewhere on the board
VSYS: BZ1.1 (+), C12.1, C13.1, D7.1 (K), U8.2 (VCC), U8.3 (VCC); also elsewhere on the board

Notes on the sheet:
PUENTE H L9110S (alimentado desde VSYS, REQ-PER-002)
MOTORREDUCTOR
SENSOR AMBIENTAL I2C (AHT20)
SENSOR IR FC-51 CON ALIMENTACIÓN CONMUTADA
SENSOR MAGNÉTICO / FINALES DE CARRERA
BOTÓN MANTENIMIENTO
LEDs DE ESTADO (REQ-FUN-006)
BUZZER DE ALARMA
ORIFICIOS DE MONTAJE

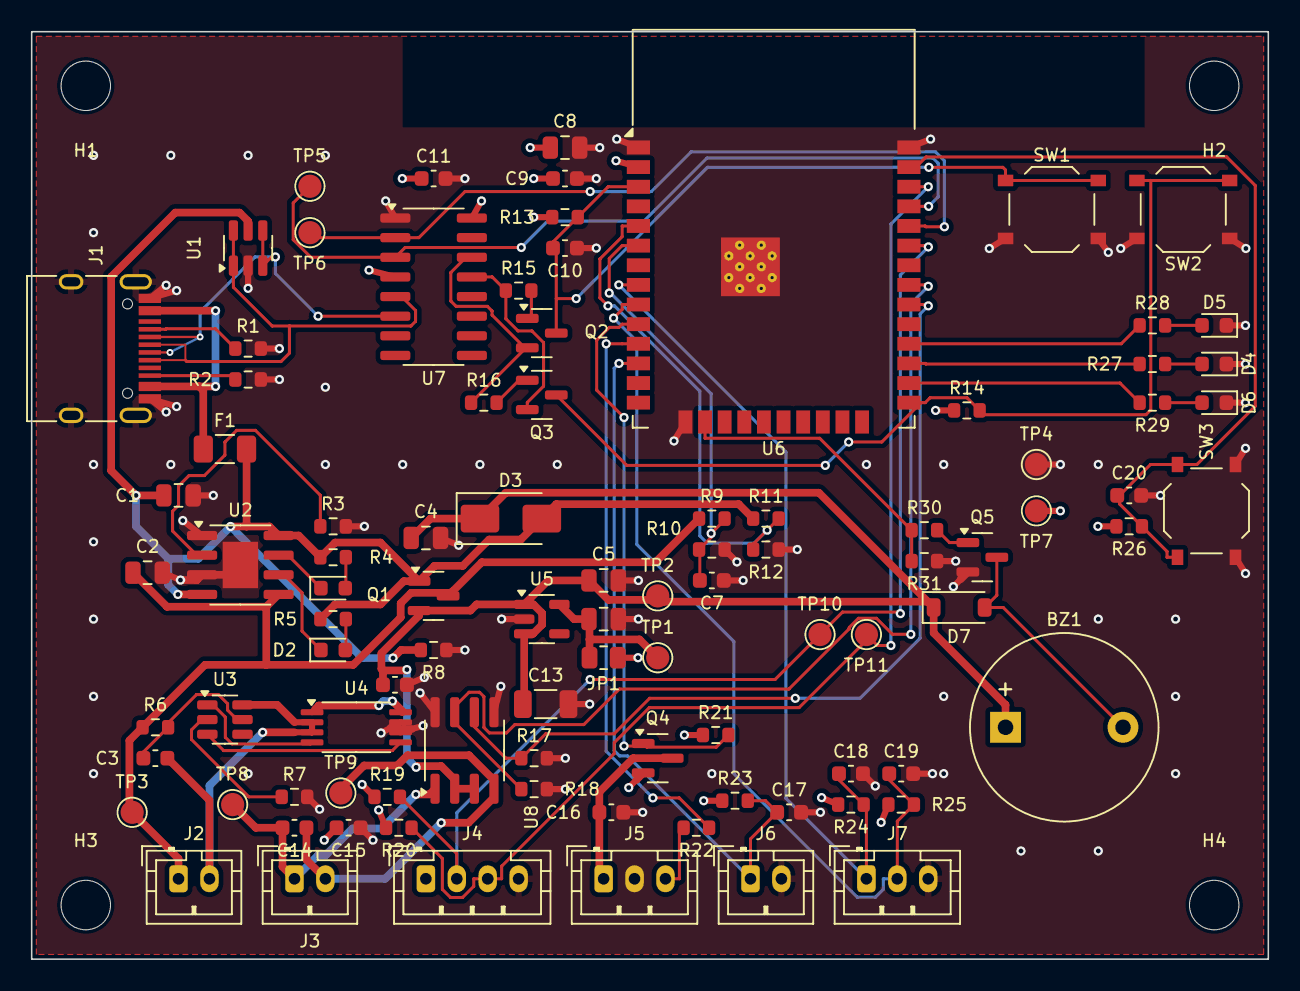
[picture p17: board estacion.kicad_pcb from above]

Board: 4 copper layers, 80.0 x 60.0 mm, 99 parts (0 on the bottom side), 55 nets.
