jacoboropero-web/segunda-entrega-proyecto/firmware/include/secrets.example.h

// Copiar como secrets.h y completar. secrets.h no debe subirse al repositorio.
#pragma once
#define WIFI_SSID  "nombre_red"
#define WIFI_PASS  "clave_red"
#define MQTT_HOST  "192.168.1.10"
#define MQTT_PORT  1883
